botguywes/RemoteMeasurementAndMonitoring/Project/Code/Raspberry Pi/opencv/images/grey.jpg

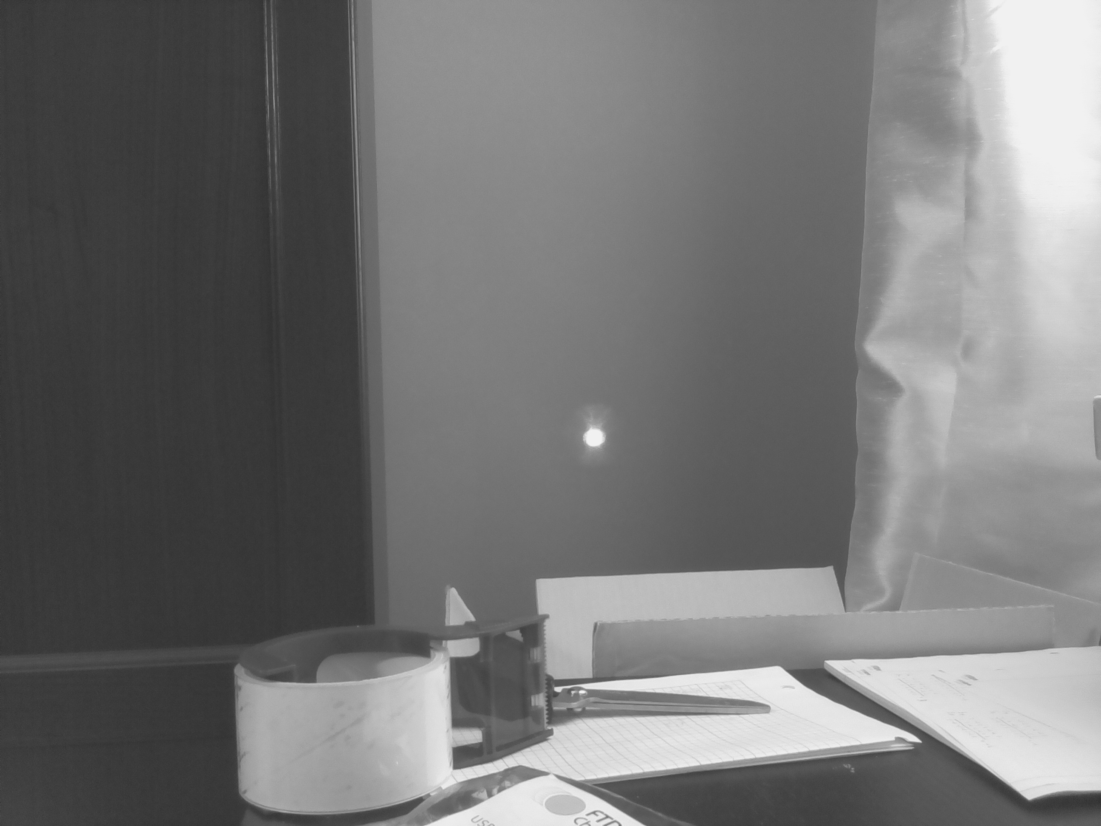
Project/Code/Raspberry Pi/opencv/images/grey.jpg
