botguywes/RemoteMeasurementAndMonitoring/Project/Code/SIFT Algorithm/power_substation.jpg

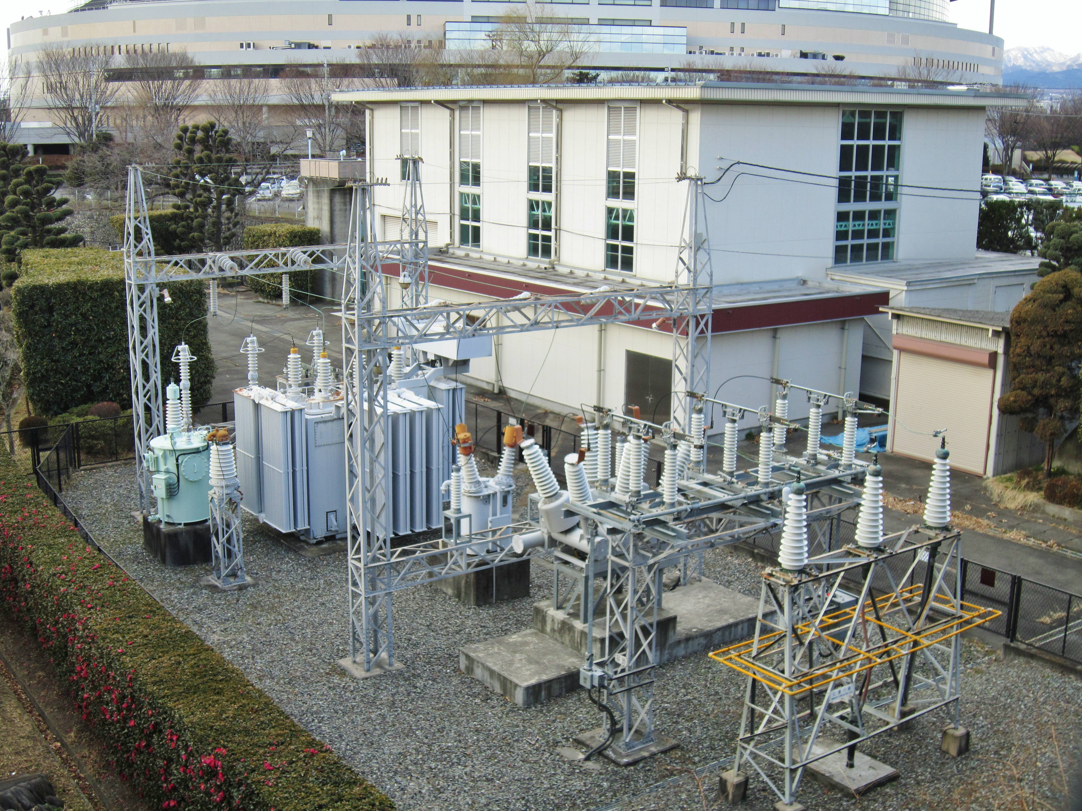
Project/Code/SIFT Algorithm/power_substation.jpg
