botguywes/RemoteMeasurementAndMonitoring/Diagrams/Diagrams.pptx

CSI
Bus

GPIO

Raspberry Pi

Webserver

OpenCV

Range Finder

Pan Servo

Tilt Servo

Rasbperry Pi Camera

## Slide 2

.02 m

theta = .23 degrees

50 m
