botguywes/RemoteMeasurementAndMonitoring/CDR/Diagrams/CDR_diagrams/CDR_diagrams .pptx

1-degree

1-degree

TL

TR

BL

BR

TL-TR

TR-BR

BR-BL

BL-TL

TL-BR

BL-TR

## System Layout

CSI
Bus

GPIO

Range Finder

Raspberry Pi

Webserver

OpenCV

Raspberry Pi Camera

Pan Servo

Tilt Servo

USB

WiFi Dongle

## Slide 3

Requirement Driver

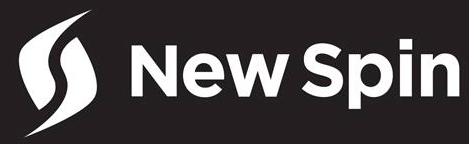
[picture p42: figure]

Remote Measurement

Web Interface Control

Remote Viewing

Autonomy for Monitoring

## Slide 4

FSM Overview

User Selects Target to Measure within FOV

Yes

Aimed?

No

Execute Measurement Algorithm

Display Information to User

Aim Pan-Tilt Towards Target

Notes: LPF
R = 1 kOhm
C = 15 micro Farads
