botguywes/RemoteMeasurementAndMonitoring/CDR/Diagrams/Website.pptx

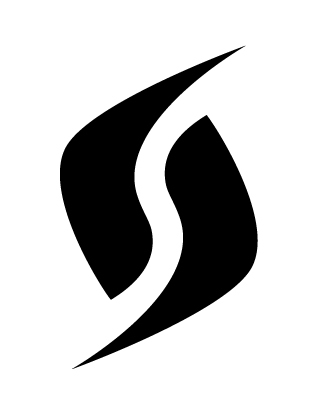
[picture p43: figure]

New Spin

Home

Config

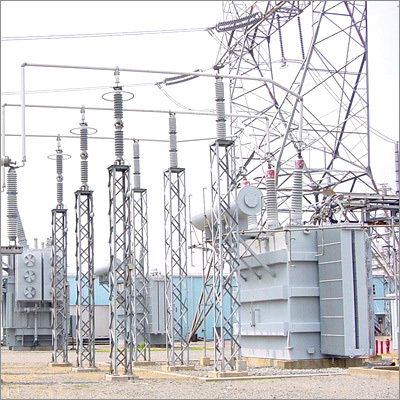
[picture p44: figure]

Create Target List

20.21 meters

Distance:

See measurement Graph

## Slide 2

New Spin

Home

Config

Notification Center

Automated Detection

enable notifications:

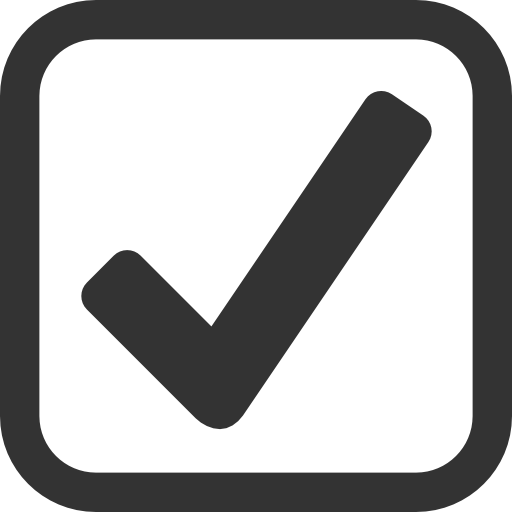
[picture p45: figure]

autoscan:

email:

phone:

john@doe.com

Target Deck:

MyList.xml

123-456-7890

carrier:

AT&T
