botguywes/RemoteMeasurementAndMonitoring/Project/Code/Raspberry Pi/opencv/images/thresh.jpg

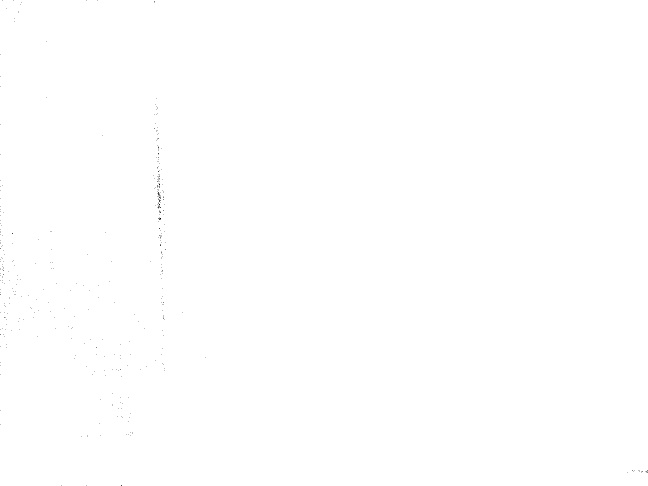
Project/Code/Raspberry Pi/opencv/images/thresh.jpg
